rgregg/esp32-environmental-sensor/docs/superpowers/specs/2026-09-29-enclosure-design.md

# 3D-Printable Enclosure — Design

**Date:** 2026-09-29
**Status:** Draft — awaiting operator review

## Goal

A wall-mountable, 3D-printable enclosure that holds the Olimex
**ESP32-POE-ISO** and the **MOD-ENV** (BME280 + CCS811) as one unit, keeps the
sensor out of the board's heat, and keeps USB (power) and reset reachable with
the case closed. Parametric OpenSCAD source lives in the repo.

**Success criteria**

1. Both boards fit and are held securely; the Ethernet and USB plugs seat fully.
2. Both printed parts print in PETG on FDM **without supports**.
3. After ≥1 h closed and running, BME280 temperature is within **0.5 °C** of a
   reference thermometer placed beside the unit.

## Decisions (operator-selected)

- **Placement:** indoor, wall-mounted.
- **Sensor:** MOD-ENV only (no MOD-BME280 variant).
- **CAD:** OpenSCAD, source in repo; STLs generated by script.
- **Material:** PETG, FDM.
- **Power/cabling:** USB power + separate non-PoE Ethernet (two cables).
- **Access with lid closed:** USB port, reset button. No LED window.
- **Architecture:** single unit with an isolated, vented sensor chamber
  (chosen over a hanging sensor pod and an external-face sensor).
- **Layout:** vertical, **Ethernet at the top**, sensor chamber at the bottom
  (chosen over an L-shaped side pod with Ethernet at the bottom).
- **Ribbon:** keep the stock 150 mm UEXT cable, with a slack pocket.
- **Tooling:** OpenSCAD run from the official Docker image (Docker is available
  on the dev machine); AppImage in `~/.local/bin` is the fallback. No sudo.

## Non-goals

- MOD-BME280 support, PoE-only deployments, outdoor/weatherproofing.
- LED light pipes / windows; access to the user button (firmware doesn't use it).
- Firmware temperature-offset compensation (thermal bias is fixed mechanically;
  see Verification).
- STEP export or other CAD formats.
- CI rendering of the enclosure (can be added later; renders are checked by the
  local check script).

## Source data

All board geometry is taken from Olimex's KiCad files (parsed Edge.Cuts,
footprint positions, 3D-model bounding boxes):

- ESP32-POE-ISO **Rev N1**:
  `github.com/OLIMEX/ESP32-POE-ISO/.../HARDWARE/ESP32-PoE-ISO-Rev.N1/ESP32-PoE-ISO_Rev_N1.kicad_pcb`.
  Olimex's dimension drawing covers "Rev J and newer" and agrees.
- MOD-ENV **Rev B**: `github.com/OLIMEX/MOD-ENV/.../HARDWARE/REV-B/MOD-ENV_revB.kicad_pcb`.

### ESP32-POE-ISO (board frame: component side up, origin = PCB corner at the RJ45 end, X across the 28 mm width, Y along the length)

| Feature | Value |
|---|---|
| PCB | 28.00 × 98.15 × 1.6 mm |
| Mounting holes | 3 × Ø2.2 non-plated: MH1 (7.64, 2.73), MH2 (2.56, 70.68), MH3 (25.42, 70.68) |
| RJ45 (LPJ4112CNL) | X 11.05–27.05, overhangs Y=0 edge by 8.14 mm, height 13.3 |
| micro-USB | on X=0 edge, Y 31.80–39.20 (centre 35.5), face ≈ flush with X=0, height ≈2.7 |
| UEXT (2×5 shrouded) | body X 3.83–24.15, Y 59.37–68.26, height ≈9.1; key faces RJ45 |
| Reset (RST1) | centre (2.17, 88.33), top-actuated, ≈2.0 tall |
| ESP32 module | Y 78.96–104.46 — antenna overhangs the far edge by 6.3 mm |
| Tallest top parts | RJ45 13.3; electrolytics ≈11.5; DCDC1 10.2; UEXT 9.1 |
| Bottom side | THT leads + parts up to ≈2.7 mm → **4 mm under-board clearance** |
| Heat sources (USB-powered) | ESP32 module (antenna end), LAN8710 PHY (bottom, ≈(15.3, 51.2)) |

### MOD-ENV (Rev B)

| Feature | Value |
|---|---|
| PCB | 21.59 × 19.685 × 1.6 mm; **no mounting holes** |
| Locating slot | oval 3.2 × 4.5 mm centred (10.80, 16.36) (between the sensors) |
| UEXT header | along one 21.59 mm edge, 1.65 mm inset, height ≈9 (tallest part) |
| BME280 / CCS811 | (4.57, 16.76) / (17.14, 16.28) — on the edge **opposite** UEXT |
| Bottom side | no components |

### Values to verify with calipers before the full print

- IDC plug height above the header's PCB (estimated 15–16 mm installed) —
  drives case depth.
- Which side of the MOD-ENV header the key faces.
- The bench board's revision (expect J–N1).

## Case coordinate frame

Right-handed. Viewed from the front (lid toward viewer): **x** to the right,
**y up** from the outer bottom surface, **z** from the back (wall side) toward
the lid. (A y-down frame with z toward the viewer would be left-handed and
would silently mirror the model — USB would end up on the wrong side.)

The board mounts component side toward the lid, rotated 180° in-plane so the
RJ45 is at the top: `case_x = board_left + (28 − bx)`, `case_y = board_top − by`.
Consequently the USB, reset button, and LED column land on the **right** side;
the RJ45 sits left of centre at the top.

## Design

### 1. Overall form

- Two printed parts: **base** (back + side walls + internal structure; screws
  to the wall) and **lid** (front face).
- Outer size **33.6 W × 154.6 H × 29 D mm** (190.6 mm tall including the
  mounting ears; all derived from parameters).
  - Width: 28 mm board + clearance + 2 mm walls.
  - Depth: driven by the UEXT IDC plug (plug + ribbon ≈17.5 mm above the PCB,
    PCB at 6 mm above the back) → 25 mm internal. *(Grew from the ≈25 mm total
    quoted in discussion once the IDC plug height was accounted for.)*
  - Height, top to bottom: top wall, RJ45 jack depth, 98.15 mm board, 6.3 mm
    antenna overhang, baffle, sensor chamber, bottom wall.
- Walls 2 mm. One global `tolerance` parameter (default 0.3 mm) sets every
  clearance fit.

### 2. Main compartment and airflow

- Chimney airflow: **intake** slots on both side walls just above the baffle;
  **exhaust** slots in the upper side walls. Warm air from the ESP32/PHY rises
  and leaves at the top, away from the sensor. *(A single top-wall exhaust slot
  was dropped: the 4.55 mm between the RJ45 notch and the top-right boss left
  1 mm fins on either side of it, too thin to print reliably.)*
- **Board mounting:** three standoffs at the board's asymmetric holes (the board
  can only go in one way), 4 mm tall, 1.8 mm pilot holes for **M2 × 6
  self-tapping** screws. *(The RJ45 support ledge from discussion is dropped: the
  jack's through-hole leads occupy the space under that end, and mounting hole
  MH1 is only 2.7 mm from the jack end, so plug force is already carried by a
  screw.)*
- **Ribbon slack pocket:** two loops hanging from the lid underside over the
  lower main compartment (the ESP32 module region). Each loop opens 20 × 13 mm,
  large enough for the ribbon's measured 18 × 11 mm connector to pass through,
  because the free end has to be threaded before it's plugged into the MOD-ENV.
  The bar sits 1.6 mm above the module. Surplus ribbon is Z-folded between the
  lid and the bars. Ribbon path: board UEXT plug → loops → baffle notch →
  sensor chamber. *(Changed after assembly: the first loops, 14.5 × 5.5 mm, were
  too small for the connector.)*
- A **double wall with a 3 mm air gap** spanning the full cavity width, between
  the main compartment and the sensor chamber, sitting below the antenna
  overhang with ≥1.5 mm clearance.
- A **ribbon notch open toward the lid** (≈14 × 2 mm after the lid tongue
  closes it) lets the ribbon drop in during assembly. The lid carries a matching
  tongue that closes the notch.

### 4. Sensor chamber

- About 30 mm of internal height.
- MOD-ENV mounted **face-out, UEXT header at the top, sensor edge at the
  bottom**, so the BME280/CCS811 sit closest to incoming air.
- Retention: four corner ledges (a 1 mm shelf under each PCB corner plus a
  locating wall); a peg rising from the floor through the module's
  oval slot (locates it); a lid rib bearing on the IDC plug (stops it lifting).
  The ribbon may need a half twist to match pin 1 — that's acceptable.
- ≈8 mm of open air space below the module's sensor edge (also clears the bottom-corner lid bosses).
- Vents: **intake** through the chamber's bottom face; **outlet** through the
  lower side walls and the lid front. **No openings between the chamber and the
  main compartment** other than the sealed ribbon notch.

### 5. Closure (refined in detail design)

The four-corner screws presented in discussion don't fit: the board fills the
full cavity width, so there is no corner space for an M3 insert boss (needs
≈Ø7 mm) along the board. Revised:

- **Five M3 heat-set inserts** (hole Ø5.0 × 7 mm, to match the inserts on hand) in
  Ø8.5 base bosses. The bosses are sized from the insert (≥1.5 mm of wall all round)
  and inset by their radius so they merge into the case walls. They take
  **M3 × 8 button-head screws** whose heads sit on the lid face (a 2 mm lid is too
  thin to counterbore):
  - **Top-right** corner: the region right of the RJ45, above the board.
    To make room, the RJ45 face is recessed **1.5 mm** inside the top wall's
    outer surface (opening sized for the plug body, so the plug still seats
    fully), which gives ≈7.6 mm above the board edge.
  - **Baffle left and right:** bosses merged into the baffle's side ends.
  - **Chamber bottom left and right:** in the corners below/beside the module.
- A 1 mm locating lip on the lid fits inside the base walls (alignment, and
  closes the seam).

### 6. Wall mounting (refined in detail design, twice)

Keyholes cut through a 2 mm floor would put the wall-screw heads inside the
4 mm under-board gap, where they would collide with the RJ45 and other
through-hole leads. The first fix, keyholes in two 4.5 mm rails on the back,
was dropped during prototyping: printing the base back-down would leave the
floor between the rails as an unsupported bridge about 100 mm long. Final
design:

- Two **mounting ears**, 16 × 18 × 3 mm, flush with the back plane: one above
  the top wall and one below the bottom wall, centred on the width. Each has a
  keyhole with an Ø8.5 mm entry hole and a 4.2 mm slot running 7 mm above it.
  The screw head sits in front of the ear, which is clamped between the head and
  the wall.
- For #6/#8 (3.5–4 mm) wood or drywall screws with heads up to 8 mm, set
  **≈172.5 mm apart** vertically. Leave the heads ≈3.5 mm proud of the wall.
- The unit hangs by sliding **down** onto the two screws, and lifts off without
  opening it.
- The case sits flat against the wall. The Ethernet cable passes in front of the
  top ear, since the plug sits ≥7 mm in front of the back plane.

### 7. Ports and access

- **RJ45:** a U-notch in the top wall, open toward the lid, sized for the plug
  body plus clearance. The jack face is recessed 1.5 mm (see §5). A lid tab fills
  the notch above the jack. The plug latch stays outside the case.
- **USB:** a 12 × 9 mm opening in the right wall, centred on the micro-USB, with a
  45° peaked roof so its top prints without an 11 mm bridge. The wall is thinned
  to 1.2 mm around it so overmolded plugs seat fully; that outside pocket has a
  45° chamfered ceiling for the same reason.
- **Reset:** a Ø2 mm pinhole in the lid over RST1, with a guide tube ending
  1.5 mm above the button so a paperclip lands on it.

### 8. Printing

- **Base:** printed back-down, ears on the bed. Only short bridges: the tops of
  the vent slots and of the USB opening. Standoffs, bosses,
  baffle and guides print vertically.
- **Lid:** printed face-down. The reset tube, chamber rib, notch tab and tongue,
  slack clips and lip print upward. The clip bars are 16 mm bridges.
- Vent slots are 1.5–2 mm wide with 2 mm ribs.
- **Recommended settings:** 0.2 mm layers, 3 perimeters, 20 % infill.

## Deliverables (`hardware/enclosure/`)

- `params.scad`: every dimension, with board data transcribed from the tables
  above.
- `boards.scad`: board placement transforms, plus `board_keepouts()`. These are
  simple solids for both PCBs (including the MOD-ENV and its IDC plug),
  connectors, tall parts, the plugs' insertion paths and the under-board
  clearance.
- `base.scad`: `base()` and `fit_test()`.
- `lid.scad`: `lid_assembled()` for checks and `lid()` in print orientation.
- `enclosure.scad`: the entry point. `-D 'part="…"'` selects `base`, `lid`,
  `fit_test`, `assembly` (keepouts shown as ghosts) or one of the check parts.
- `tools/openscad.sh`: runs OpenSCAD with the Manifold backend from a
  **digest-pinned** `openscad/openscad:dev` Docker image. The `latest` tag is the
  2021.01 release, which has no Manifold backend. With
  `OPENSCAD_NO_DOCKER=1`, or when Docker isn't available, it uses `openscad`
  from PATH (the AppImage).
- `tools/stl_report.py`: reports an STL's volume and the bounding boxes of any
  clashing parts. Needs Python 3 only (standard library).
- `check.sh`: the automated verification below.
- `export.sh`: renders `build/stl/{base,lid,fit_test}.stl`.
- `README.md`: parts list (5 × M3 heat-set inserts, 5 × M3 × 8 button-head
  screws, 3 × M2 × 6 self-tapping screws, 2 wall screws), print settings,
  assembly order, the caliper checks, and a board-revision note.
- Generated output goes in `hardware/enclosure/build/`, which is git-ignored.
  STLs are not committed.
- A short "Enclosure" pointer in the top-level README.

## Verification

1. **Automated (`check.sh`):**
   - `base`, `lid` and `fit_test` each render to a non-empty mesh with no
     warnings.
   - **Interference:** `intersection() { case; board_keepouts(); }` must have
     **zero volume** (<0.01 mm³). Faces that only touch, such as the PCB on its
     standoffs, are allowed. This covers board edges, every connector, the RJ45
     and USB plug insertion paths, the antenna overhang, and the under-board
     clearance.
   - The assembled base and lid have zero-volume overlap.
   - **Envelope:** nothing on the base (apart from the ears) and nothing on the
     lid extends outside the outer box.
   - **Self-test:** the case box intersected with the keepouts must be
     *non*-empty. This proves the clash check can fail.
2. **Fit test (manual):** print `fit_test.stl`, a thin slice with the floor,
   standoffs, and the wall ring carrying the RJ45 and USB openings (≈20 min).
   Confirm the holes line up and both plugs seat.
3. **Full print and assembly (manual):** everything fits, the lid closes with
   no bowing, the paperclip hits reset, and the unit hangs on the keyholes.
4. **Thermal (manual):** after ≥1 h closed and running, the BME280 reading is
   within 0.5 °C of a reference thermometer beside the unit. If it reads high,
   the fixes are mechanical: more chamber venting, or a wider baffle gap or a
   taller chamber.

## Risks

- **Estimated heights** (IDC plug, some component heights) may be off. The
  depth is a parameter, and the caliper checks come before the full print.
- **The ESP32 sits just above the baffle.** This layout was chosen over the
  side pod for compactness. The air-gap baffle plus separate airflow paths are
  the mitigation, and the thermal check is the proof.
- **The CCS811 self-heats slightly** (a few mW), right next to the BME280 on
  the module itself. The enclosure can't fix this. The chamber airflow keeps it
  from building up.
