rgregg/esp32-environmental-sensor/(list of files, cad)

Other CAD files:
hardware/enclosure/boards.scad
hardware/enclosure/params.scad
hardware/enclosure/base.scad
hardware/enclosure/enclosure.scad
hardware/enclosure/lid.scad
