rgregg/esp32-environmental-sensor/src/bme280_sensor.cpp

#include "bme280_sensor.h"

bool Bme280Sensor::begin() {
  present_ = dev_.begin(0x76) || dev_.begin(0x77);
  // Bosch's weather-monitoring settings: one conversion per read, no oversampling.
  // The library default (normal mode, x16, 0.5 ms standby) samples continuously
  // and measurably self-heats the sensor (~0.35 °C in the enclosure).
  if (present_)
    dev_.setSampling(Adafruit_BME280::MODE_FORCED, Adafruit_BME280::SAMPLING_X1,
                     Adafruit_BME280::SAMPLING_X1, Adafruit_BME280::SAMPLING_X1,
                     Adafruit_BME280::FILTER_OFF);
  return present_;
}

bool Bme280Sensor::read() {
  if (!present_) return false;
  if (!dev_.takeForcedMeasurement()) return false;
  lastTemp_ = dev_.readTemperature();
  lastHum_ = dev_.readHumidity();
  float pressure = dev_.readPressure() / 100.0f;  // Pa -> hPa
  haveEnv_ = true;
  readings_.clear();
  addReading(readings_, "temperature", lastTemp_, "°C");
  addReading(readings_, "humidity", lastHum_, "%");
  addReading(readings_, "pressure", pressure, "hPa");
  return true;
}

bool Bme280Sensor::hasEnv(float& tempC, float& humidity) const {
  if (!haveEnv_) return false;
  tempC = lastTemp_; humidity = lastHum_;
  return true;
}
