rgregg/esp32-environmental-sensor/(commit log)

2026-07-20 Add design spec for PoE environmental sensor firmware
2026-07-20 Add implementation plan for PoE environmental sensor
2026-07-21 Pin native test env to framework-agnostic sources
2026-07-21 chore: scaffold PlatformIO project with dual-OTA partitions and native test env
    [partitions.csv]
2026-07-21 fix: declare 16MB flash size so OTA slot 2 and LittleFS map correctly
2026-07-21 Pin pioarduino platform for arduino-esp32 core 3.x
    Bare `platform = espressif32` was ambiguous between the official platform
    (core 2.0.17) and the installed pioarduino platform (core 3.3.7). The design
    targets core 3.x / ESP-IDF 5.x and the firmware uses 3.x APIs, so pin
    pioarduino 55.03.37 explicitly for reproducible builds.
2026-07-21 feat: add sensor abstraction, SensorManager, and BME280 auto-detect
2026-07-21 feat: add CCS811 air-quality sensor with BME280 compensation
2026-07-21 fix: reconfigure watchdog for 30s + guard boot wait; clamp publish interval; guard empty-readings discovery
    [main.cpp, mqtt_publisher.cpp]
2026-07-21 fix: harden watchdog, network timeouts, publish-interval floor, and HA discovery
    [http_publisher.cpp, main.cpp, mqtt_publisher.cpp, web_server.cpp]
2026-07-21 docs: add SDD progress ledger (decisions + deferred on-device checklist)
    Records the subagent-driven build: per-task review outcomes, root-cause fixes
    (4MB->16MB flash, hardware-atomics build_unflags, watchdog reconfigure), and the
    deferred on-device verification checklist for when the hardware arrives.
2026-07-24 feat: generate and print an API token on first boot
2026-07-24 fix: accept API token for OTA upload via shared credential check
    [web_server.cpp]
2026-07-25 docs: record on-device bench verification results
    All previously-deferred hardware checks now run on the real board
    (ESP32-POE-ISO, 16MB, at 10.0.1.93). Ethernet/DHCP, mDNS, BME280 readings,
    config persistence, web UI auth, CSRF, rate limiting, API token, and two full
    OTA round trips all pass. The final review's watchdog finding is confirmed real
    and the reconfigure fix is proven effective (survived a 10s unfed block that
    would panic under the 5s default).
2026-07-25 feat: instrument-panel web UI; fix partial-POST defaults; print IP on boot
    Three changes found during on-device bench testing:
    - POST /config: mqttEnabled, mqttDiscovery and httpEnabled defaulted to
    hardcoded values instead of their current setting, so a partial/scripted
    POST silently flipped them. They now default to the current value, matching
    otaEnabled. Booleans render as <select> rather than 0/1 text inputs so the
    form always submits an explicit value (an unchecked checkbox would be
    omitted and could never turn a setting off).
    - main.cpp now prints "Network up: http://<ip>/ (<name>.local)" after
    netBegin, or an explicit failure line. Finding the device previously meant
    s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
    [main.cpp, web_server.cpp]
2026-07-27 chore: stop tracking the local SDD progress ledger
2026-09-18 fix: keep CCS811 readings visible and make the sensor snapshot thread-safe (#2)
    SensorManager::poll() ran every ~50 ms loop and cleared/rebuilt the
    snapshot each time, but the CCS811 only produces a sample once per
    second, so its eco2/tvoc values were almost never present when the API,
    dashboard, or publishers read the snapshot.
    The async web server also read snapshot() (by reference) and detected()
    from the AsyncTCP task while the loop task mutated them, which showed up
    as sporadic `null` responses from /api/readings and risked a
    use-after-free on vector reallocation.
    - Build the snapshot from each sensor's last good readings
    - Guard snapshot and sensor pointers with a mutex; snapshot() r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
    [main.cpp, sensor_manager.cpp, sensor_manager.h, web_server.cpp]
2026-09-18 fix: apply MQTT broker changes immediately and correct HA units (#3)
    - Changing the MQTT host/port/credentials (or disabling MQTT) never
    dropped the existing connection, so the device kept publishing to the
    old broker until that socket happened to die. configure() now
    disconnects when connection settings change, decided by a new
    host-testable mqttConnectionSettingsChanged().
    - Config saves arrive on the AsyncTCP task; they now only set a flag and
    loop() reconfigures the publishers, so the MQTT client is no longer
    touched from two tasks.
    - Home Assistant discovery: tvoc (ppb) uses the
    volatile_organic_compounds_parts device class (the plain class is for
    ug/m3), and temperature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
    [bme280_sensor.cpp, main.cpp, mqtt_format.cpp, mqtt_format.h, mqtt_publisher.cpp]
2026-10-01 feat: add 3D-printable wall-mount enclosure (OpenSCAD) (#5)
    * docs: add 3D-printable enclosure design spec
    * docs: include MOD-ENV in enclosure keepout check
    * docs: add enclosure implementation plan; amend spec from prototyping
    Prototyping in OpenSCAD surfaced changes now reflected in the spec: right-handed
    y-up frame, mounting ears instead of back rails (rails would print as a ~100 mm
    bridge), M3x8 button-head lid screws, no RJ45 ledge, 12x9 USB opening,
    volume-based clash checks plus envelope and orientation checks.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
    [base.scad, boards.scad, enclosure.scad, lid.scad, params.scad, printcheck.scad]
2026-10-01 fix: reduce sensor self-heating (BME280 forced mode, pulsed CCS811, 80 MHz CPU) (#6)
    Measured in the printed enclosure against a BLE reference thermometer, the
    BME280 read about +2.9 °C high. Controlled experiments on the bench board
    attributed it to:
    - the CCS811 hotplate in drive mode 1 (continuous), next to the BME280:
    about 1.8 °C
    - BME280 library defaults (normal mode, x16, 0.5 ms standby), sampling
    continuously: about 0.35 °C
    - ESP32 heat reaching the sensor chamber: the rest; 80 MHz trims about
    0.1-0.2 °C
    Now: BME280 forced mode at x1 (one conversion per read), CCS811 drive mode 3
    (one measurement a minute), CPU at 80 MHz. Steady-state offset in the
    enclosure: about +0.75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
    [bme280_sensor.cpp, ccs811_sensor.cpp, main.cpp, sensor_manager.cpp]
